ashishjoy19/Urumi-Nema-17-Node-/Hardware/3D/Renders/V1.1.0_Front.png

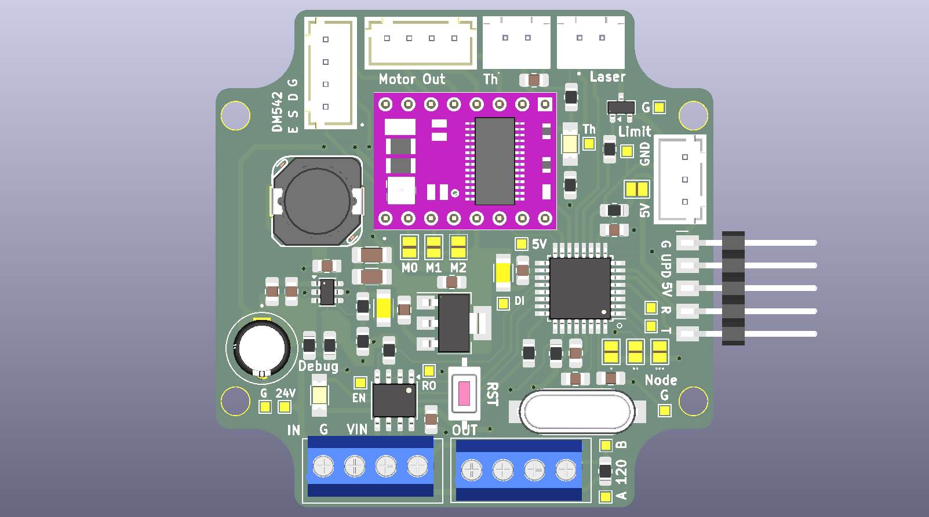
Hardware/3D/Renders/V1.1.0_Front.png
