ashishjoy19/Urumi-Nema-17-Node-/Docs/Images/urumi-node-v2.2-pcb-f.png

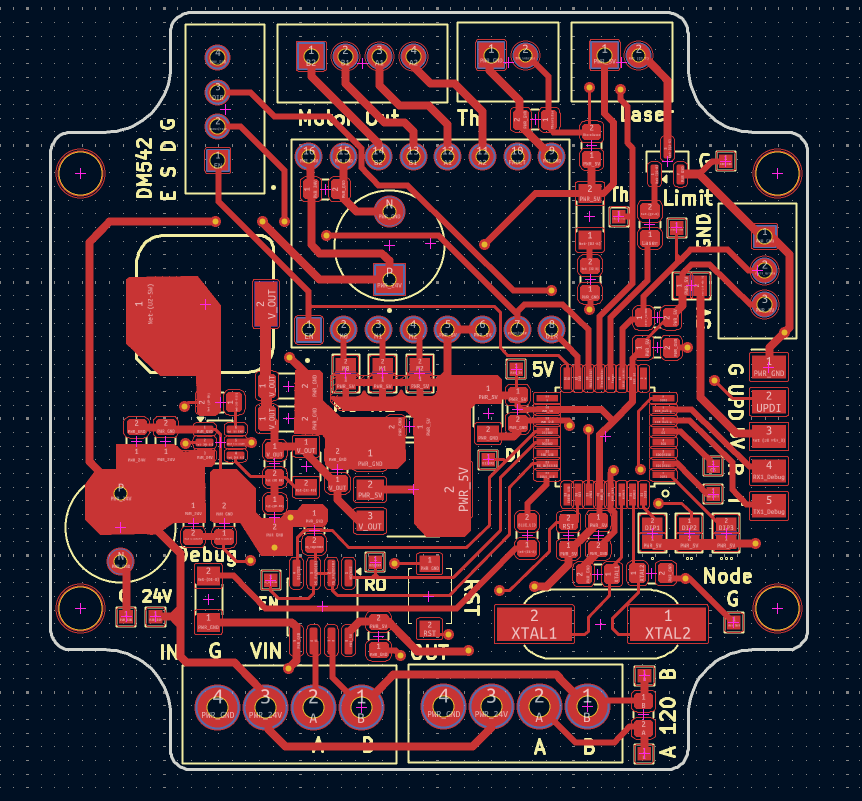
Docs/Images/urumi-node-v2.2-pcb-f.png
