ashishjoy19/Urumi-Nema-17-Node-/Docs/Images/urumi-node-v2.2-schematic.png

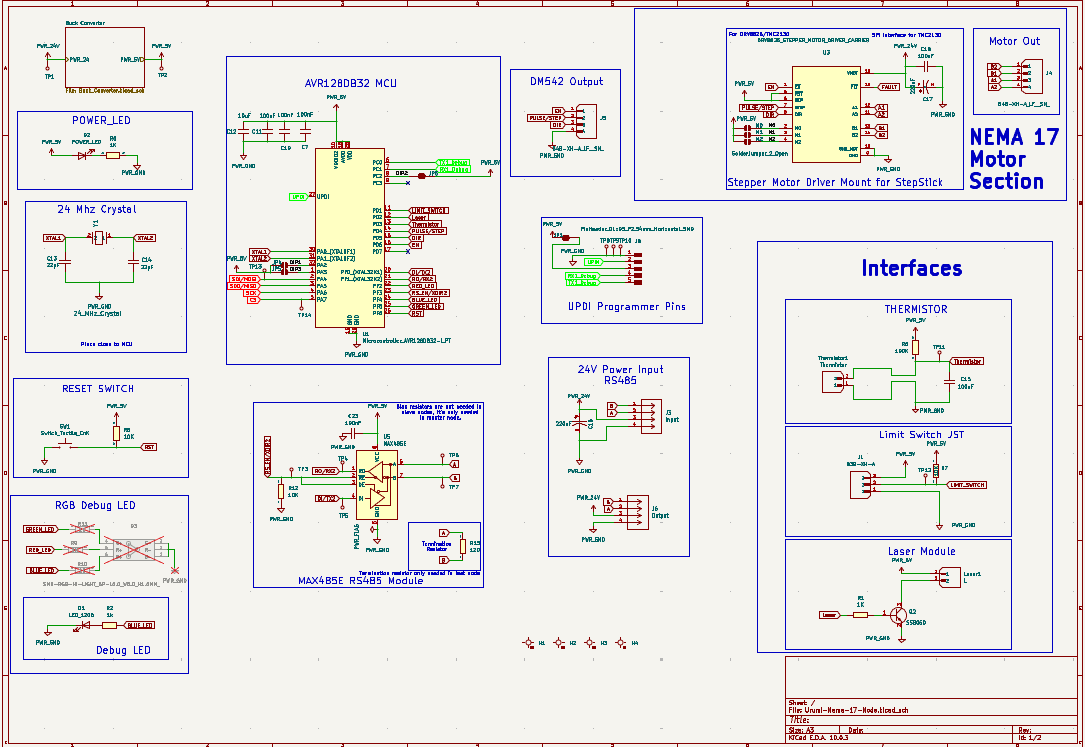
Docs/Images/urumi-node-v2.2-schematic.png
