ashishjoy19/Urumi-Nema-17-Node-/Hardware/3D/CAD/v1.1.0.step

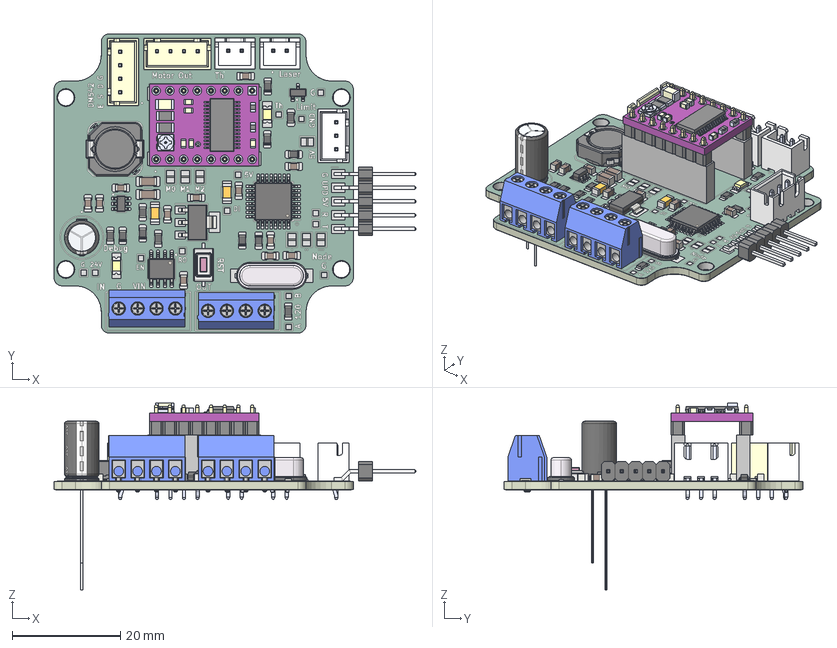
[picture p7: CAD file, 2026-07-04]
Hardware/3D/CAD/v1.1.0.step
67.0 x 55.4 x 34.5 mm
C_0805_2012Metric x 13
R_0805_2012Metric x 12
TQFP-32_7x7mm_P0.8mm
C_1206_3216Metric x 2
Screw Terminal Block 3.5mm Blue 4-way v2 x 2
crystal-smd
LeadA
LeadB
Cover
Button
SOT-23-6
Pin x 5
Insulation x 5
Base x 2
Emmiter x 2
Contact_1 x 2
Contact_2 x 2
B2B-XH-A(LF)(SN) x 2
CDRH104R
Contact x 2
ContactClone x 2
DRV8825 STEPPER MOTOR DRIVER CARRIER
SOIC-8_3.9x4.9mm_P1.27mm
BxB-XH-A_03
Elco 100uF-35V (6.3 x 11 mm)
SOT-223
SOT-23
Urumi-Nema-17-Node_copper
Urumi-Nema-17-Node_pad
Urumi-Nema-17-Node_via
Urumi-Nema-17-Node_silkscreen x 2
Urumi-Nema-17-Node_soldermask x 2
Urumi-Nema-17-Node_PCB
