ashishjoy19/Urumi-Nema-17-Node-/Docs/Images/urumi-node-v2.2-schematic.pdf

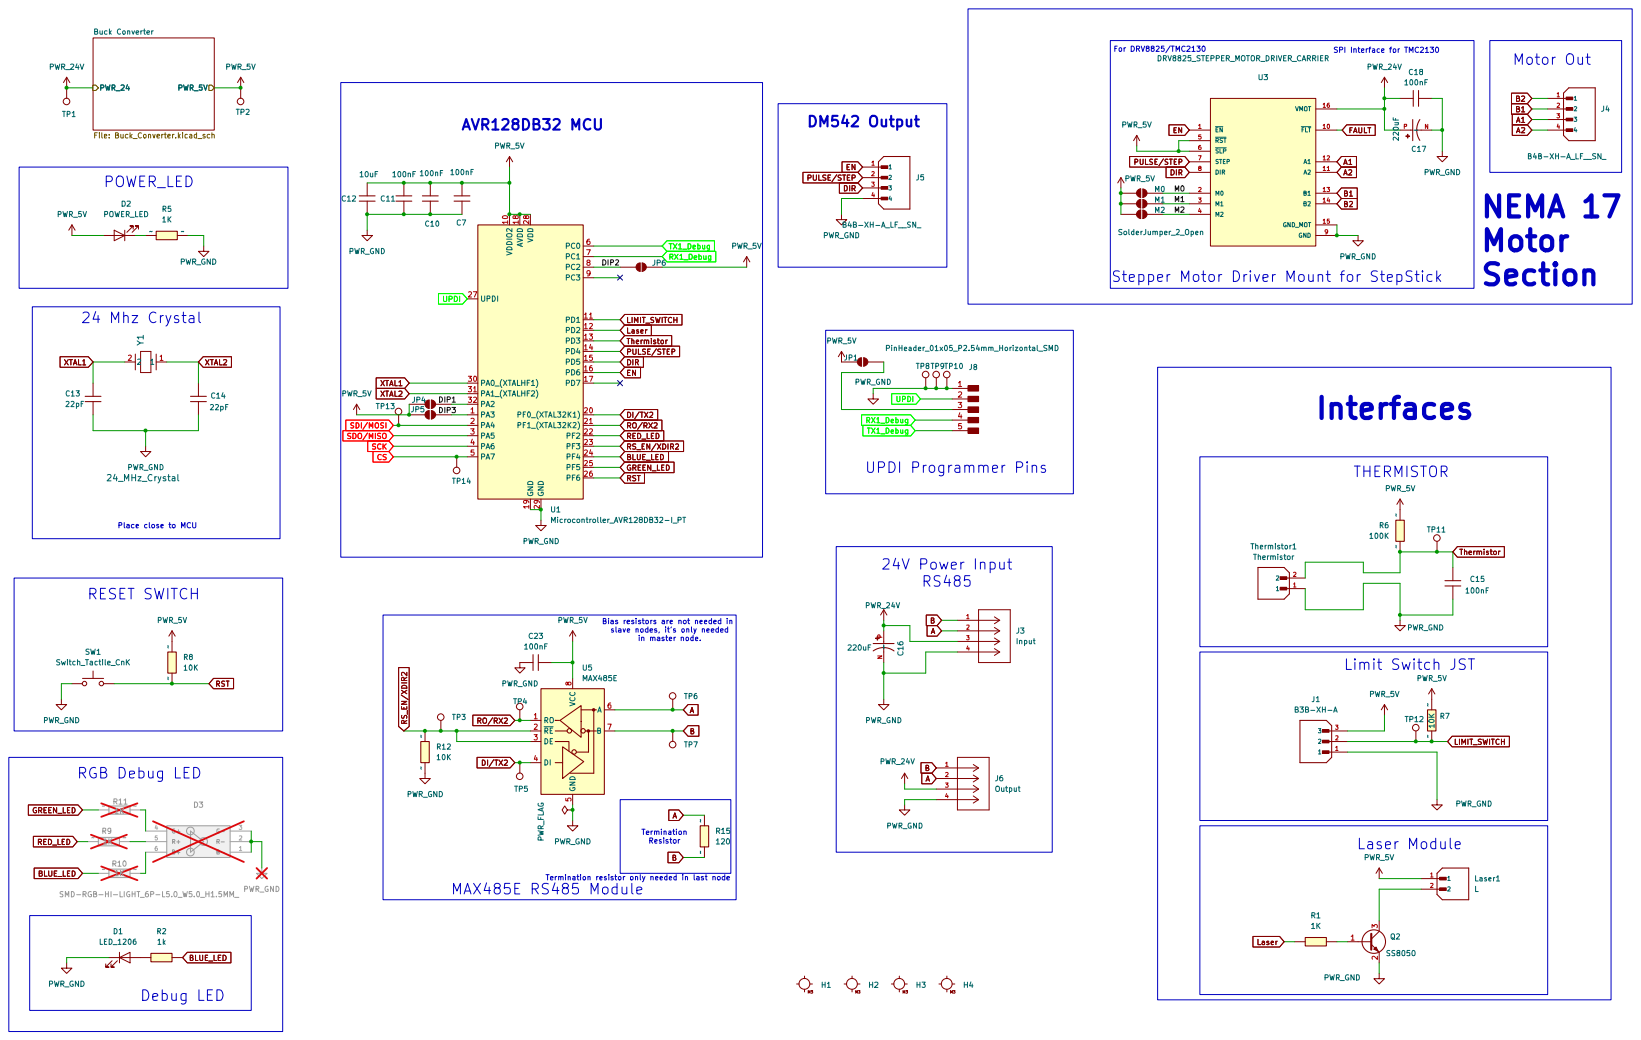
[picture p8: page 1]

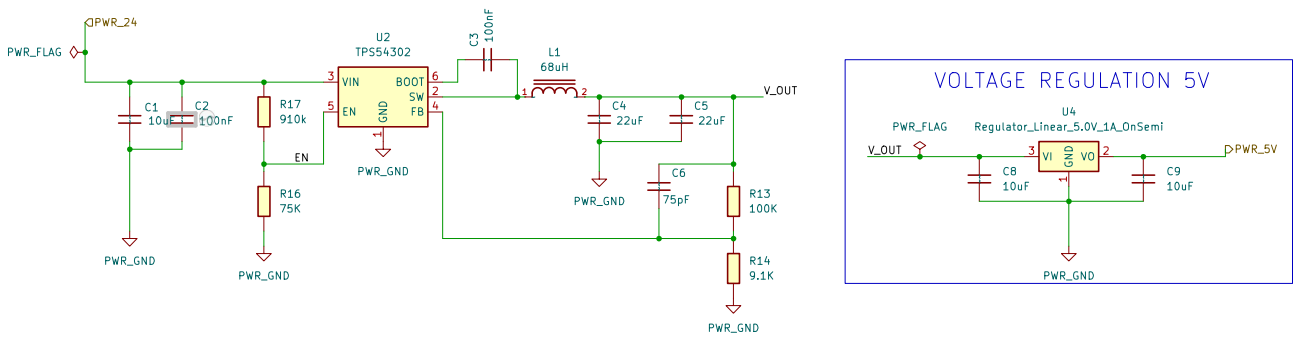
[picture p9: page 2]
