ashishjoy19/Urumi-Nema-17-Node-/Hardware/Schematic/v1.1.0.pdf

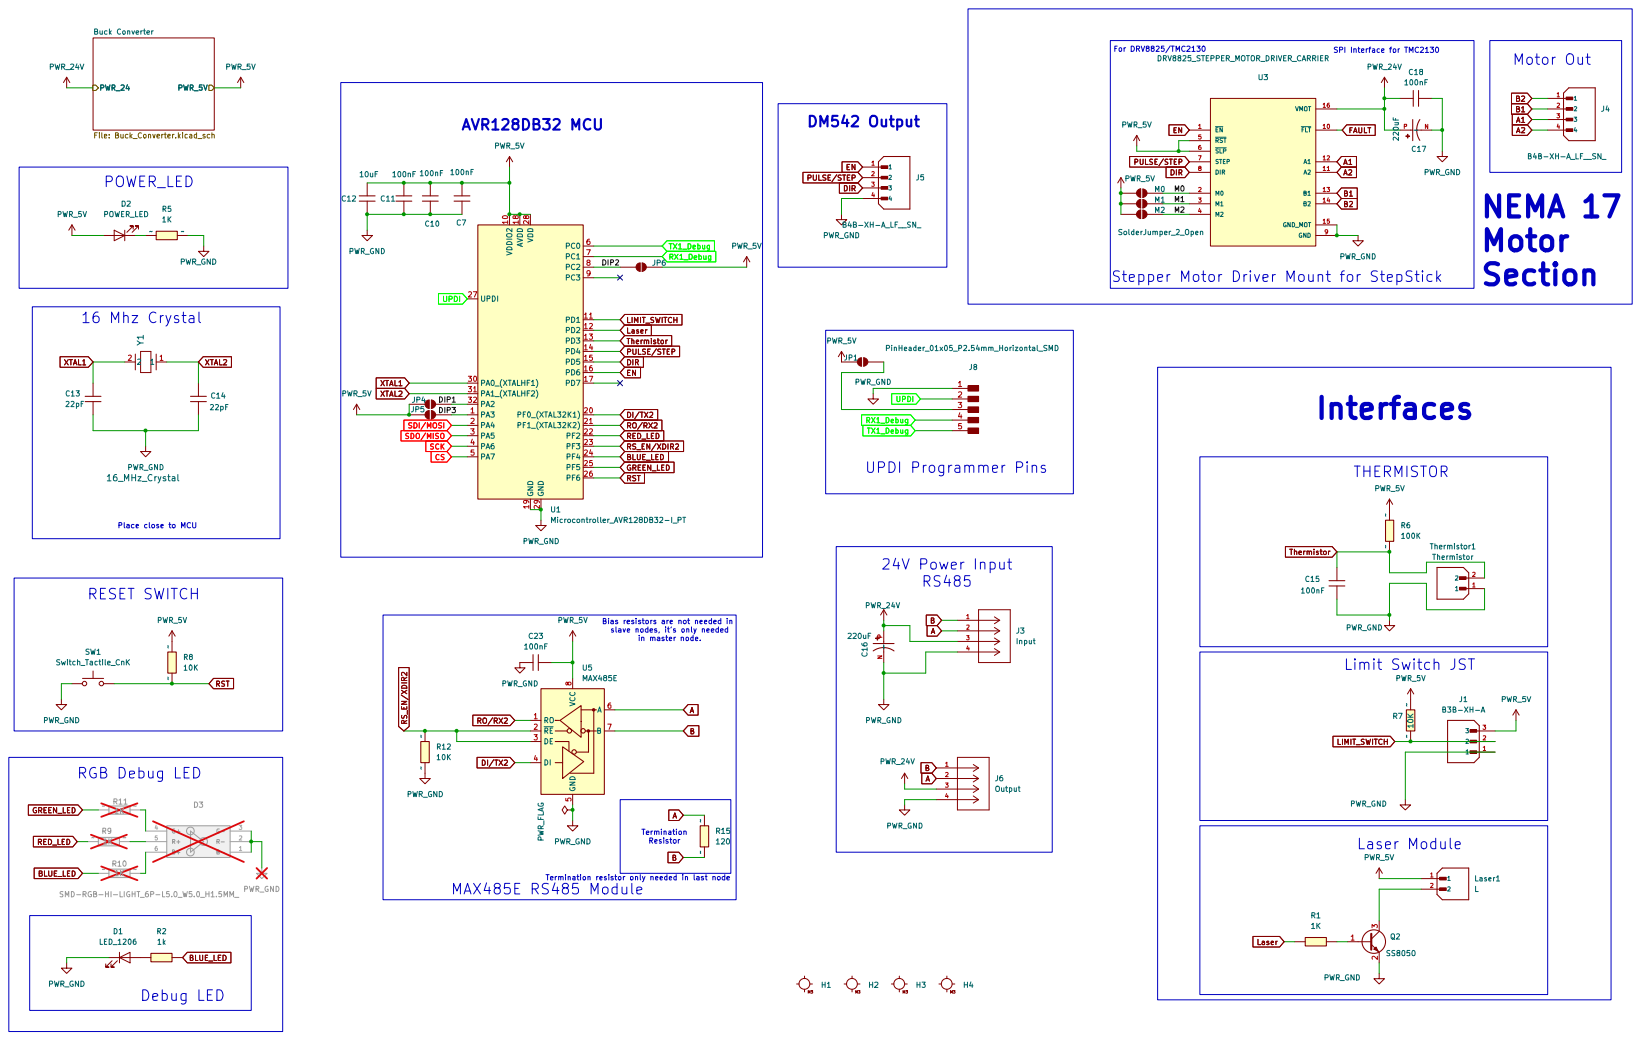
[picture p10: page 1]
