ashishjoy19/Urumi-Nema-17-Node-/Docs/Images/urumi-node-v2.2-pcb-b.pdf

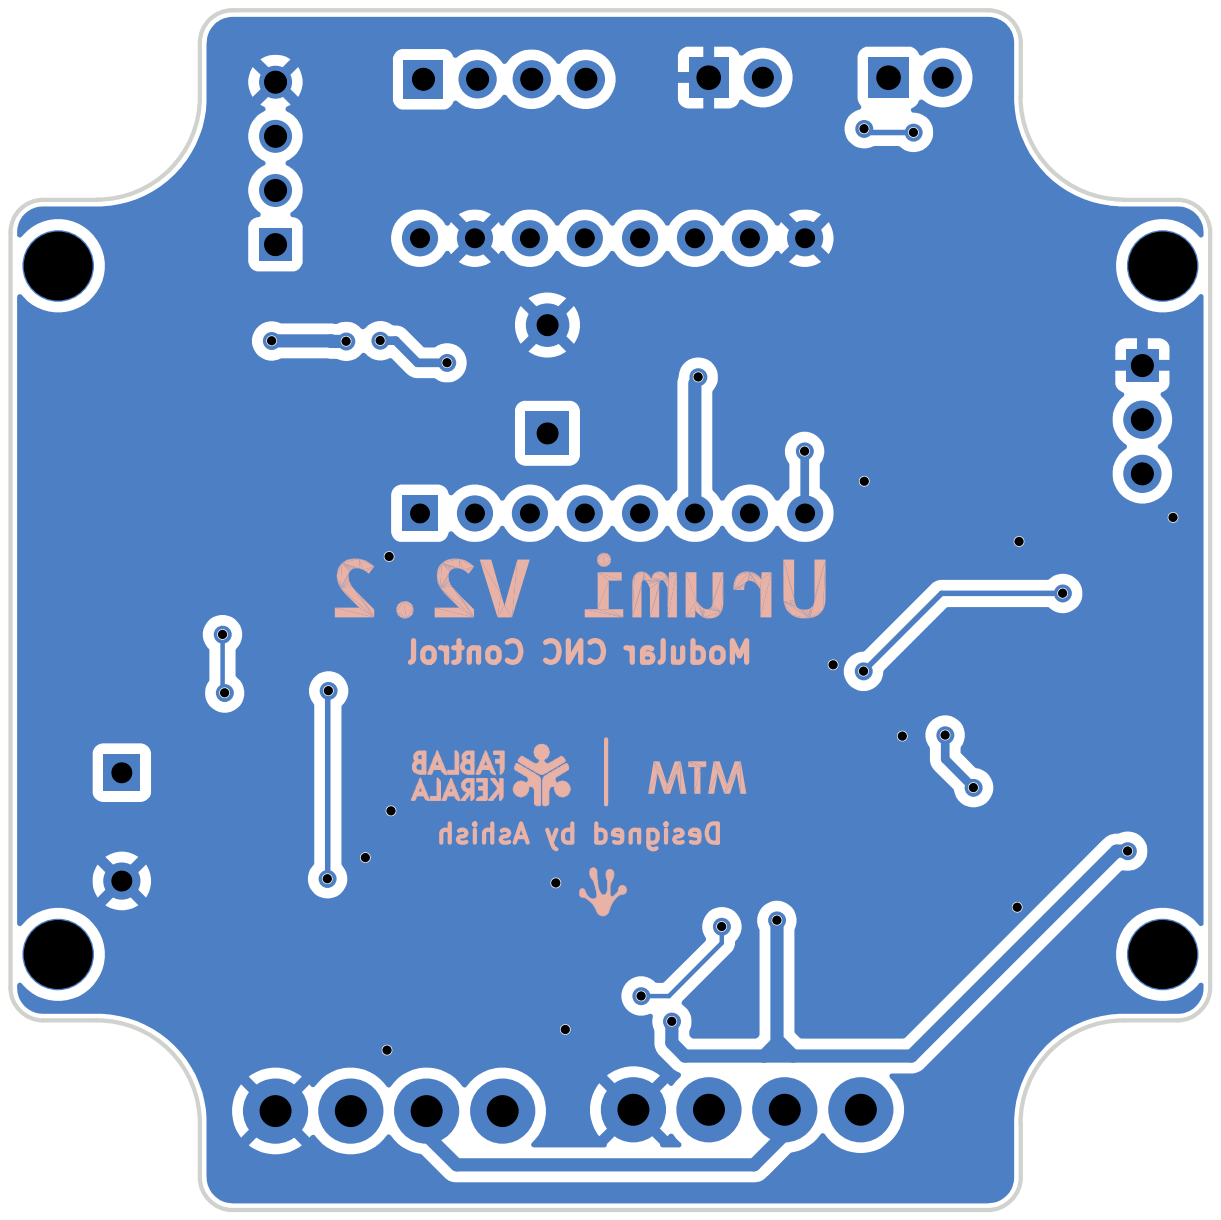
[picture p11: page 1]
