ashishjoy19/Urumi-Nema-17-Node-/Docs/Images/urumi-node-v2.2-pcb-f.pdf

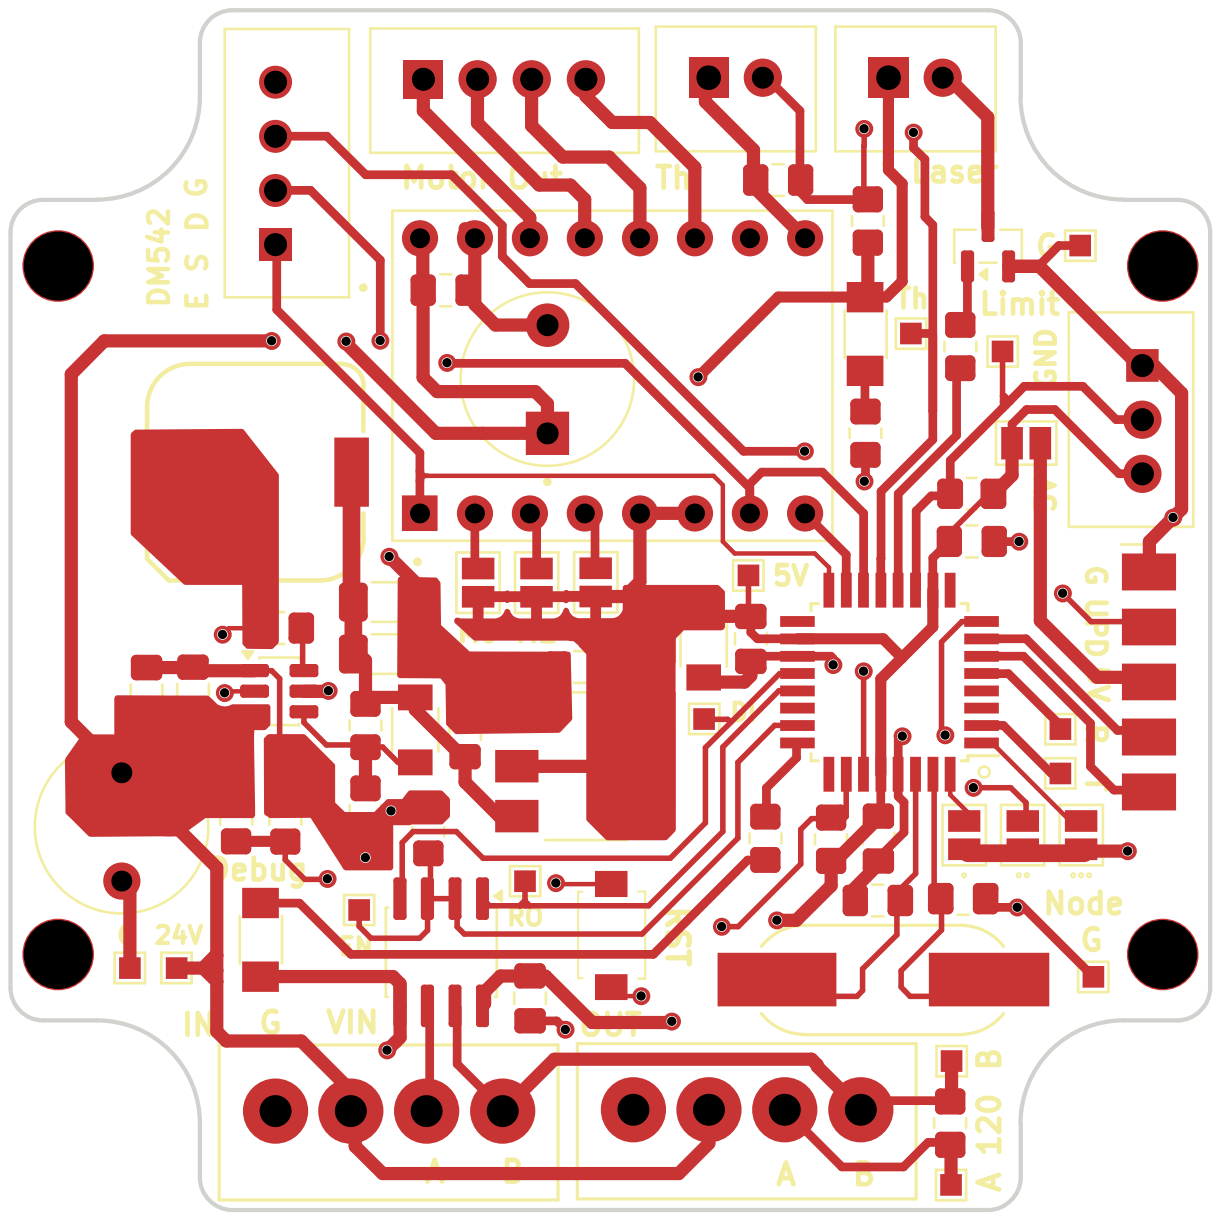
[picture p12: page 1]
