ashishjoy19/Urumi-Nema-17-Node-/Hardware/KiCad/Urumi-Nema-17-Node.kicad_pcb

## KiCad design Hardware/KiCad/Urumi-Nema-17-Node.kicad_pcb (2026-07-08)

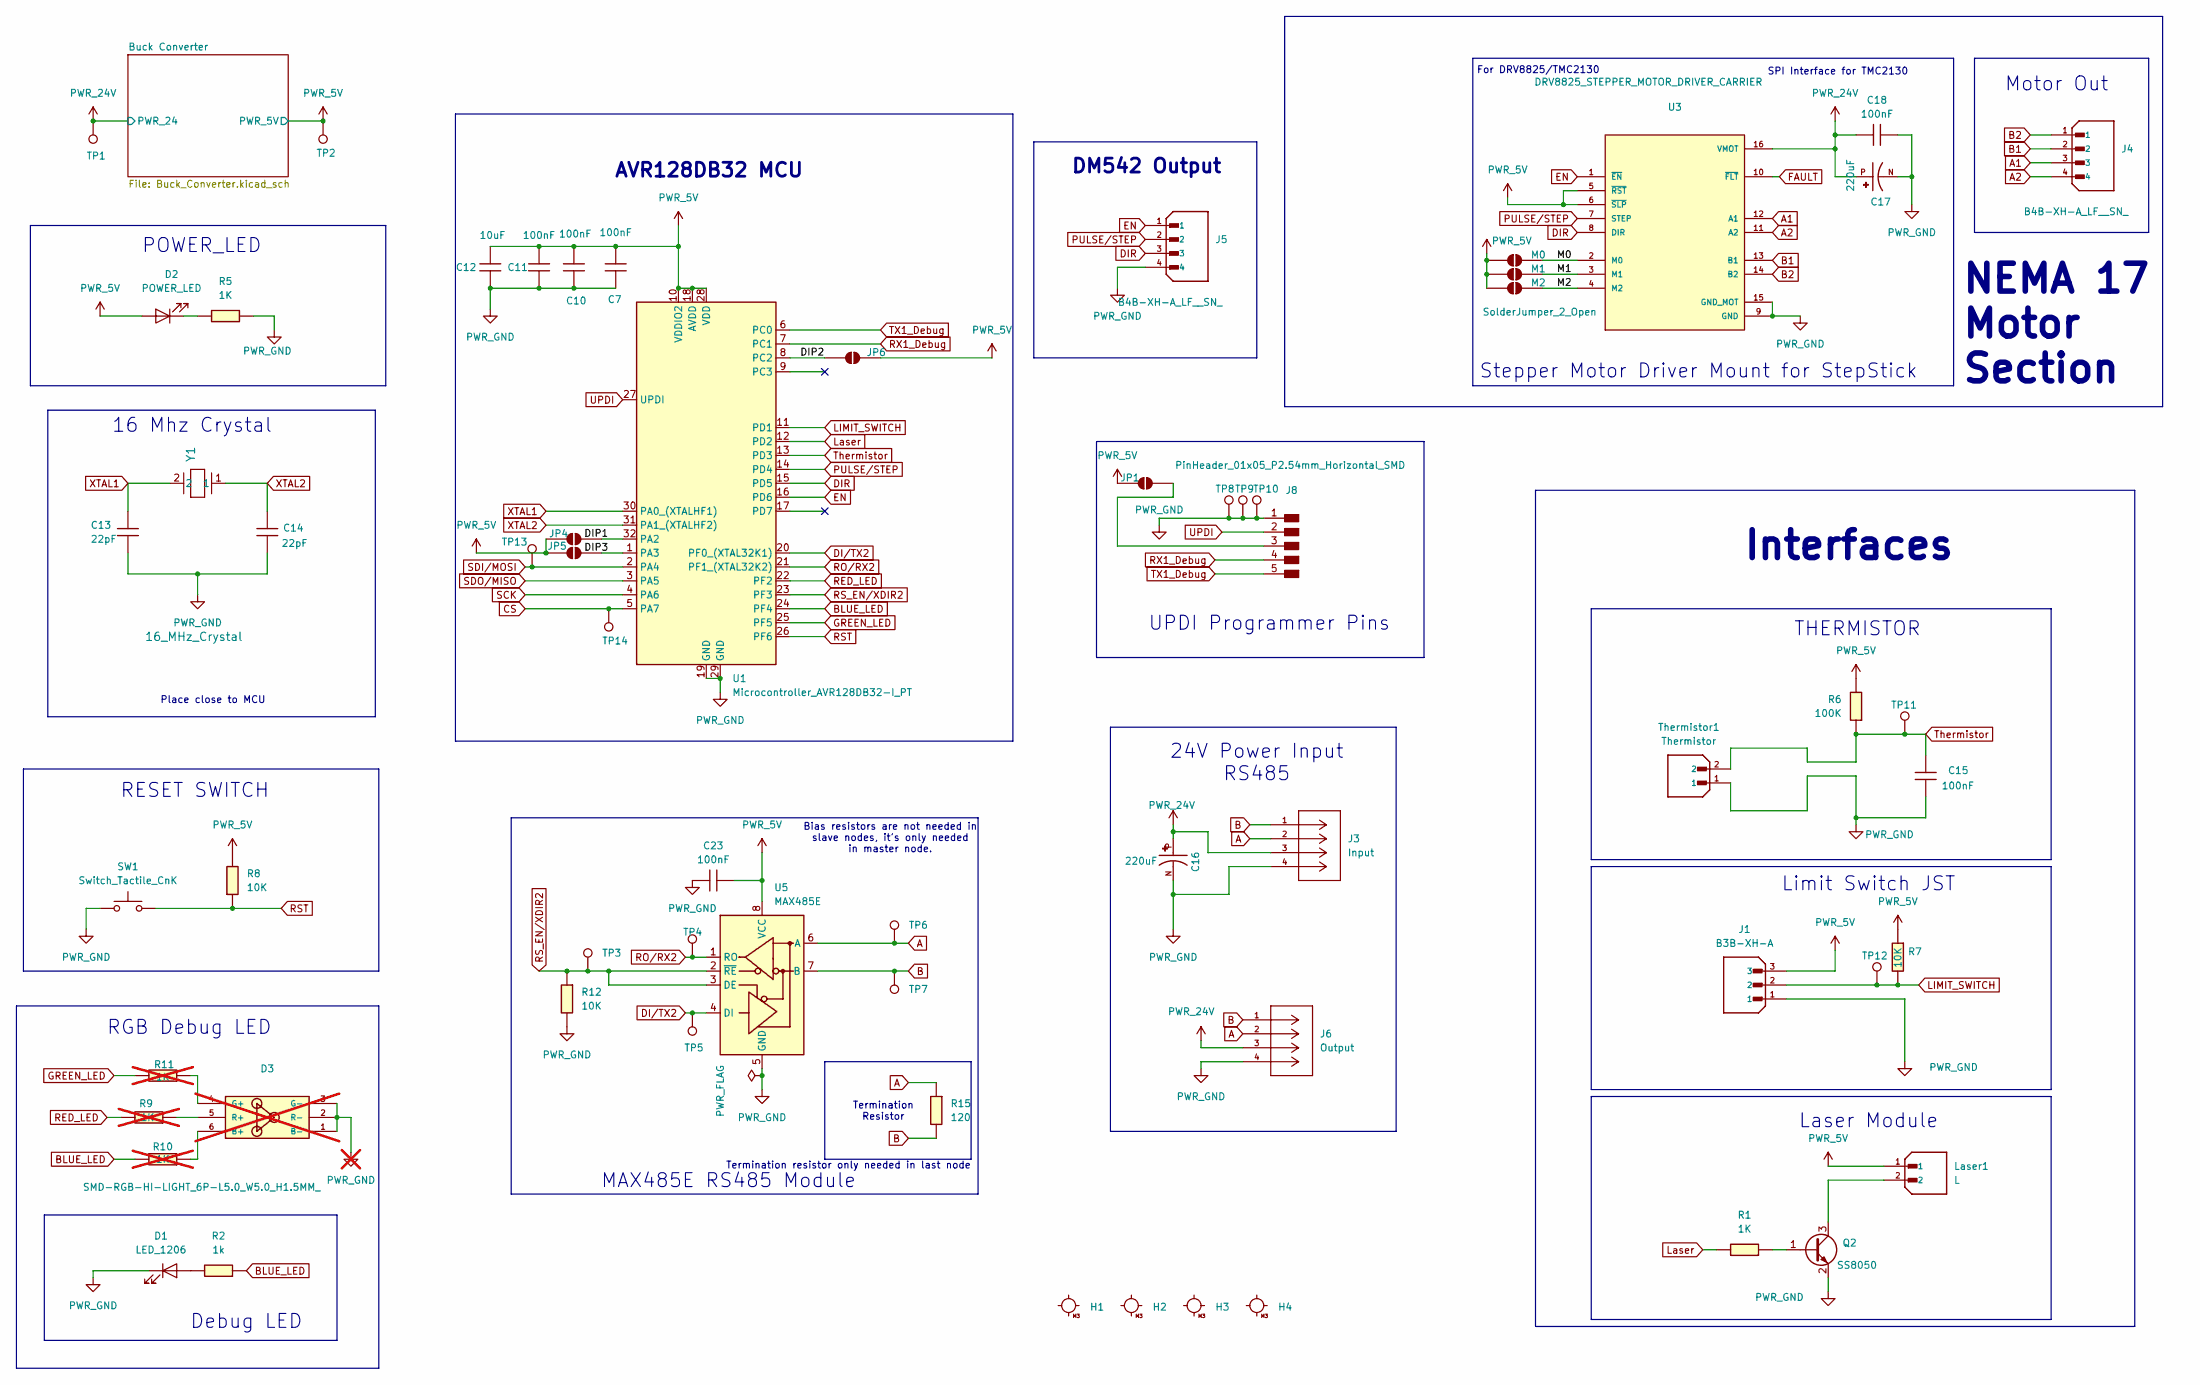
[picture p13: schematic Urumi-Nema-17-Node.kicad_sch]

Parts:
C7, C10, C11, C15, C18, C23: 100nF; C_0805_2012Metric_Pad1.18x1.45mm_HandSolder
C12: 10uF; C_1206
C13, C14: 22pF; C_0805_2012Metric_Pad1.18x1.45mm_HandSolder
C16, C17: 220uF; CAPPRD500W60D800H2000; PARTREV 28-FEB-20
D1: LED_1206
D2: POWER_LED; LED_1206
D3: SMD-RGB-HI-LIGHT_6P-L5.0_W5.0_H1.5MM_; LED6-SMD-5050; MPN 5050RGB; not fitted
H1, H2, H3, H4: MountingHole_M3
J1: B3B-XH-A; JST_B3B-XH-A; PARTREV 7/4/21
J3: Input; CONN_SD-39501-001_04P_MOL; MANUFACTURER_PART_NUMBER 395016004
J4, J5: B4B-XH-A_LF__SN_; JST_B4B-XH-A_LF__SN_; PARTREV 7/4/21
J6: Output; CONN_SD-39501-001_04P_MOL; MANUFACTURER_PART_NUMBER 395016004
J8: PinHeader_01x05_P2.54mm_Horizontal_SMD
JP1, JP4, JP5, JP6: SolderJumper_2_Open; SolderJumper-2_P1.3mm_Open_Pad1.0x1.5mm
Laser1: L; JST_B2B-XH-A_LF__SN_; PARTREV N/A
M0, M1, M2: SolderJumper_2_Open; SolderJumper-2_P1.3mm_Open_Pad1.0x1.5mm
Q2: SS8050; SOT-23
R1, R5: 1K; R_0805_2012Metric_Pad1.20x1.40mm_HandSolder
R2: 1k; R_0805_2012Metric_Pad1.20x1.40mm_HandSolder
R6: 100K; R_0805_2012Metric_Pad1.20x1.40mm_HandSolder
R7, R8, R12: 10K; R_0805_2012Metric_Pad1.20x1.40mm_HandSolder
R9, R10, R11: 1K; R_0805_2012Metric_Pad1.20x1.40mm_HandSolder; not fitted
R15: 120; R_0805_2012Metric_Pad1.20x1.40mm_HandSolder
SW1: Switch_Tactile_CnK; Button_Mini_3.9x3
TP1, TP2, TP3, TP4, TP5, TP6, TP7, TP8, TP9, TP10, TP11, TP12, TP13, TP14: TestPoint; TestPoint_Pad_1.0x1.0mm
Thermistor1: Thermistor; JST_B2B-XH-A_LF__SN_; PARTREV N/A
U1: Microcontroller_AVR128DB32-I_PT; TQFP-32_7x7mm_P0.8mm
U3: DRV8825_STEPPER_MOTOR_DRIVER_CARRIER; IC_DRV8825_STEPPER_MOTOR_DRIVER_CARRIER
U5: MAX485E; SOIC-8_3.9x4.9mm_P1.27mm
Y1: 16_MHz_Crystal; H32_RAM

Connections:
/DIP1: JP4.2 (B), U1.32 (PA2)
/DIP2: JP6.1 (A), U1.8 (PC2)
/DIP3: JP5.2 (B), U1.1 (PA3)
/M0: M0.2 (B), U3.2 (M0)
/M1: M1.2 (B), U3.3 (M1)
/M2: M2.2 (B), U3.4 (M2)
A: J3.2, J6.2, R15.2, TP6.1 (1_1), U5.6 (A)
A1: J4.3, U3.12 (A1)
A2: J4.4, U3.11 (A2)
B: J3.1, J6.1, R15.1, TP7.1 (1_1), U5.7 (B)
B1: J4.2, U3.13 (B1)
B2: J4.1, U3.14 (B2)
BLUE_LED: R2.2, R10.1, U1.24 (PF4)
CS: TP14.1 (1_1), U1.5 (PA7)
DIR: J5.3, U1.15 (PD5), U3.8 (DIR)
DI/TX2: TP5.1 (1_1), U1.20 (PF0_(XTAL32K1)), U5.4 (DI)
EN: J5.1, U1.16 (PD6), U3.1 (~EN)
FAULT: U3.10 (~FLT)
GREEN_LED: R11.1, U1.25 (PF5)
LIMIT_SWITCH: J1.2, R7.1, TP12.1 (1_1), U1.11 (PD1)
Laser: R1.1, U1.12 (PD2)
unnamed: D1.2 (A), R2.1
unnamed: D2.1 (K), R5.2
unnamed: D3.4 (G+), R11.2
unnamed: D3.5 (R+), R9.2
unnamed: D3.6 (B+), R10.2
unnamed: J8.3, JP1.2 (B)
unnamed: Q2.1 (B), R1.2
unnamed: Laser1.2, Q2.3 (C)
PULSE/STEP: J5.2, U1.14 (PD4), U3.7 (STEP)
PWR_5V: C7.1, C10.1, C11.1, C12.1, C23.2, D2.2 (A), J1.3, JP1.1 (A), JP4.1 (A), JP5.1 (A), JP6.2 (B), Laser1.1, M0.1 (A), M1.1 (A), M2.1 (A), R6.1, R7.2, R8.1, TP2.1 (1_1), U1.10 (VDDIO2), U1.18 (AVDD), U1.28 (VDD), U3.5 (~RST), U3.6 (~SLP), U5.8 (VCC); also elsewhere on the board
PWR_24V: C16.P, C17.P, C18.1, J3.3, J6.3, TP1.1 (1_1), U3.16 (VMOT); also elsewhere on the board
PWR_GND: C7.2, C10.2, C11.2, C12.2, C13.2, C14.2, C15.2, C16.N, C17.N, C18.2, C23.1, D1.1 (K), D3.1 (B-), D3.2 (R-), D3.3 (G-), J1.1, J3.4, J5.4, J6.4, J8.1, Q2.2 (E), R5.1, R12.1, SW1.1, TP8.1 (1_1), TP9.1 (1_1), TP10.1 (1_1), Thermistor1.1, U1.19 (GND), U1.29 (GND), U3.9 (GND), U3.15 (GND_MOT), U5.5 (GND); also elsewhere on the board
RED_LED: R9.1, U1.22 (PF2)
RO/RX2: TP4.1 (1_1), U1.21 (PF1_(XTAL32K2)), U5.1 (RO)
RST: R8.2, SW1.2, U1.26 (PF6)
RS_EN/XDIR2: R12.2, TP3.1 (1_1), U1.23 (PF3), U5.2 (~RE), U5.3 (DE)
RX1_Debug: J8.4, U1.7 (PC1)
SCK: U1.4 (PA6)
SDI/MOSI: TP13.1 (1_1), U1.2 (PA4)
SDO/MISO: U1.3 (PA5)
TX1_Debug: J8.5, U1.6 (PC0)
Thermistor: C15.1, R6.2, TP11.1 (1_1), Thermistor1.2, U1.13 (PD3)
UPDI: J8.2, U1.27 (UPDI)
XTAL1: C13.1, U1.30 (PA0_(XTALHF1)), Y1.2
XTAL2: C14.1, U1.31 (PA1_(XTALHF2)), Y1.1

Notes on the sheet:
RESET SWITCH
Bias resistors are not needed in slave nodes, it's only needed in master node.
MAX485E RS485 Module
THERMISTOR
16 Mhz Crystal
Termination Resistor
Laser Module
AVR128DB32 MCU
Limit Switch JST
SPI Interface for TMC2130
Interfaces
Debug LED
Termination resistor only needed in last node
RGB Debug LED
NEMA 17 Motor Section
DM542 Output
24V Power Input RS485
For DRV8825/TMC2130
Stepper Motor Driver Mount for StepStick
UPDI Programmer Pins
POWER_LED
Motor Out
Place close to MCU

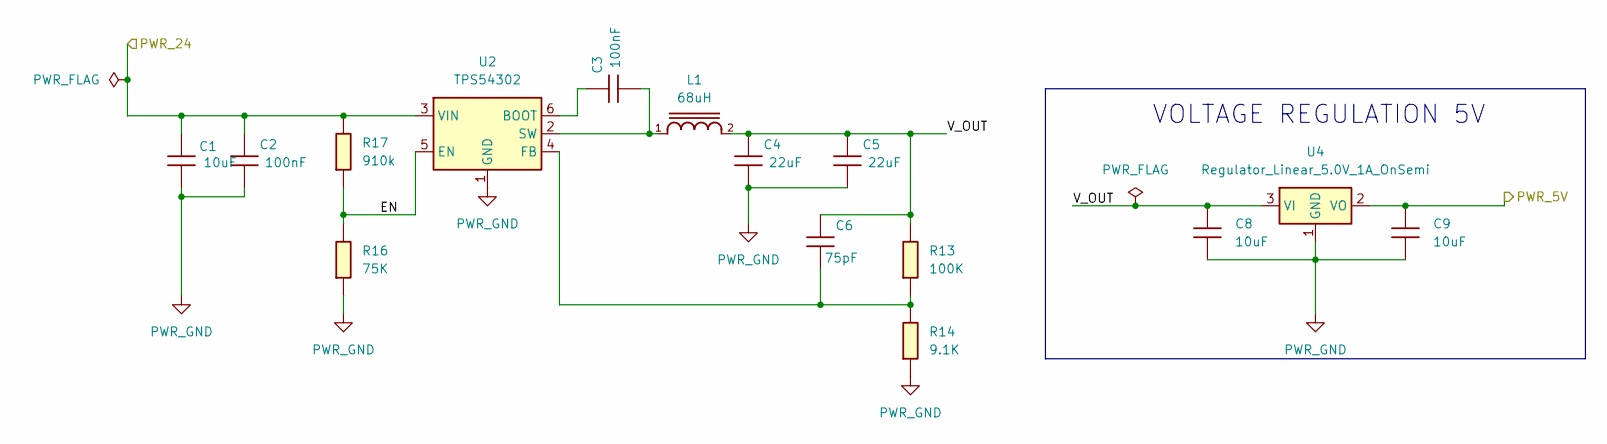
[picture p14: schematic Buck_Converter.kicad_sch]

Parts:
C1, C8, C9: 10uF; C_0805_2012Metric_Pad1.18x1.45mm_HandSolder
C2, C3: 100nF; C_0805_2012Metric_Pad1.18x1.45mm_HandSolder
C4, C5: 22uF; C_1206_3216Metric_Pad1.33x1.80mm_HandSolder
C6: 75pF; C_1206
L1: 68uH; CDRH104R
R13: 100K; R_0805_2012Metric_Pad1.20x1.40mm_HandSolder
R14: 9.1K; R_0805_2012Metric_Pad1.20x1.40mm_HandSolder
R16: 75K; R_0805_2012Metric_Pad1.20x1.40mm_HandSolder
R17: 910k; R_0805_2012Metric_Pad1.20x1.40mm_HandSolder
U2: TPS54302; SOT-23-6
U4: Regulator_Linear_5.0V_1A_OnSemi; SOT-223-3_TabPin2

Connections:
/Buck Converter/EN: R16.1, R17.2, U2.5 (EN)
/Buck Converter/V_OUT: C4.1, C5.1, C6.1, C8.1, L1.2, R13.1, U4.3 (VI)
unnamed: C3.1, U2.6 (BOOT)
unnamed: C6.2, R13.2, R14.1, U2.4 (FB)
unnamed: C3.2, L1.1, U2.2 (SW)
PWR_5V: C9.1, U4.2 (VO); also elsewhere on the board
PWR_24V: C1.1, C2.1, R17.1, U2.3 (VIN); also elsewhere on the board
PWR_GND: C1.2, C2.2, C4.2, C5.2, C8.2, C9.2, R14.2, R16.2, U2.1 (GND), U4.1 (GND); also elsewhere on the board

Notes on the sheet:
VOLTAGE REGULATION 5V

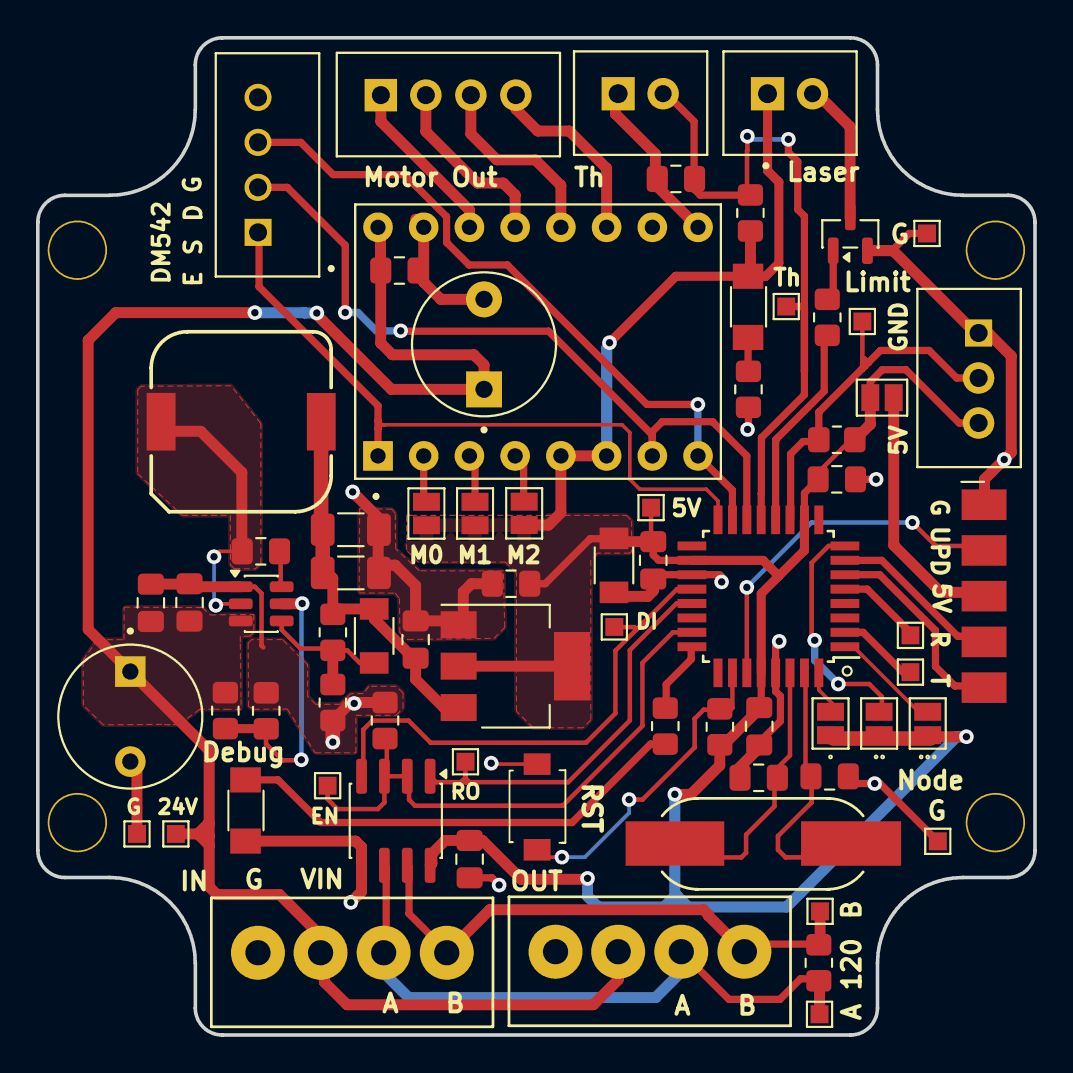
[picture p15: board Urumi-Nema-17-Node.kicad_pcb from above]

Board: 2 copper layers, 55.4 x 55.4 mm, 75 parts (0 on the bottom side), 43 nets.
