ashishjoy19/Urumi-Nema-17-Node-/(commit log)

2026-06-22 Kicad Project created
    [Urumi-Nema-17-Node.kicad_pcb, Urumi-Nema-17-Node.kicad_sch]
2026-06-22 hw: Basic schematic setup
    [Buck_Converter.kicad_sch, Urumi-Nema-17-Node.kicad_sch]
2026-06-23 hw: renamed folder
    [Buck_Converter.kicad_sch, Urumi-Nema-17-Node.kicad_pcb, Urumi-Nema-17-Node.kicad_sch]
2026-07-03 hw: v2.2 pcb ready for manufacturing
    [Buck_Converter.kicad_sch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]
2026-07-03 hw: v2.2a PCB with in and out terminals, just one debug led- no rgb
    [Urumi-Nema-17-Node.kicad_pcb, Urumi-Nema-17-Node.kicad_sch]
2026-07-03 hw: v2.2a correct one JST - final V2.2a
    [Urumi-Nema-17-Node.kicad_pcb, Urumi-Nema-17-Node.kicad_sch]
2026-07-03 hw: added gerber files for v1.0.1
    [Urumi-Nema-17-Node-B_Cu.gbr, Urumi-Nema-17-Node-B_Mask.gbr, Urumi-Nema-17-Node-B_Paste.gbr, Urumi-Nema-17-Node-B_Silkscreen.gbr, Urumi-Nema-17-Node-Edge_Cuts.gbr, Urumi-Nema-17-Node-F_Cu.gbr, Urumi-Nema-17-Node-F_Mask.gbr, Urumi-Nema-17-Node-F_Paste.gbr]
2026-07-03 hw: saved
    [Urumi-Nema-17-Node.kicad_pcb]
2026-07-03 hw: v1.0.1 corrected major mistake - didn't connect to driver to 24V
    [Urumi-Nema-17-Node-B_Cu.gbr, Urumi-Nema-17-Node-B_Mask.gbr, Urumi-Nema-17-Node-B_Paste.gbr, Urumi-Nema-17-Node-B_Silkscreen.gbr, Urumi-Nema-17-Node-Edge_Cuts.gbr, Urumi-Nema-17-Node-F_Cu.gbr, Urumi-Nema-17-Node-F_Mask.gbr, Urumi-Nema-17-Node-F_Paste.gbr]
2026-07-03 hw: added gerber for corrected hw v1.0.1
2026-07-04 hw: added test points and renders, cad
    [Urumi-Nema-17-Node-B_Cu.gbr, Urumi-Nema-17-Node-B_Mask.gbr, Urumi-Nema-17-Node-B_Paste.gbr, Urumi-Nema-17-Node-B_Silkscreen.gbr, Urumi-Nema-17-Node-Edge_Cuts.gbr, Urumi-Nema-17-Node-F_Cu.gbr, Urumi-Nema-17-Node-F_Mask.gbr, Urumi-Nema-17-Node-F_Paste.gbr]
2026-07-08 hw: final V1.1.0
    [Urumi-Nema-17-Node.kicad_pcb, Urumi-Nema-17-Node.kicad_sch]
2026-08-04 added docs
    [Urumi-Nema-17-Node.kicad_sch]
